nabilkhairii/Design-and-Development-of-an-Autonomous-Line-Follower-Robot-Using-PID-Control/README.md

# Design-and-Development-of-an-Autonomous-Line-Follower-Robot-Using-PID-Control
This project aims to design and develop an autonomous line follower robot capable of tracking paths accurately and stably using an Arduino Nano based control system and a PD (Proportional Derivative) control algorithm. The development process includes electronic and mechanical system design, PCB layout creation, hardware assembly, microcontroller programming, sensor calibration, and controller parameter tuning to achieve optimal performance. The system utilizes eight photodiode sensors read through a multiplexer for pin efficiency, an L293DN motor driver, and an OLED display for real time monitoring. 

**• Results : https://youtube.com/shorts/bV6jz2QYUdU**

**• Other Sources : https://www.linkedin.com/in/nabil-khairi-ikhsan/details/projects/**
